rchampeimont/arduino_music_on_floppy_disks/floppy_reader/README.txt

ArduinoFDC.cpp and ArduinoFDC.h are just copies of the same files from
https://github.com/dhansel/ArduinoFDC
