rchampeimont/arduino_music_on_floppy_disks/(commit log)

2021-05-27 update to latest version of ArduinoFDC
2021-05-27 add electric schematics
